RocketScientist26/Quadruped-Hardware/Servo/Manufacturing data/PCB_Bottom.png

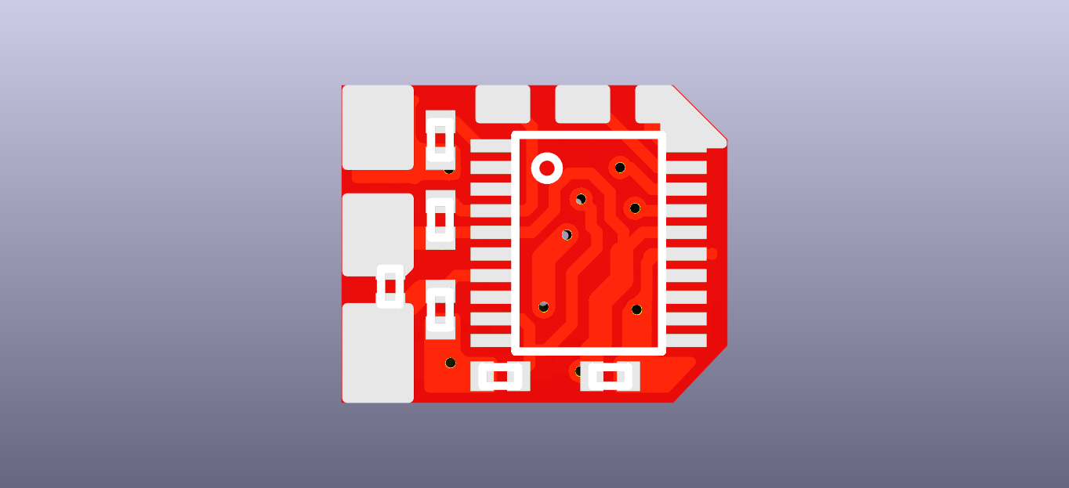
Servo/Manufacturing data/PCB_Bottom.png
