RocketScientist26/Quadruped-Hardware/Quadruped/Manufacturing data/PCB_Top.png

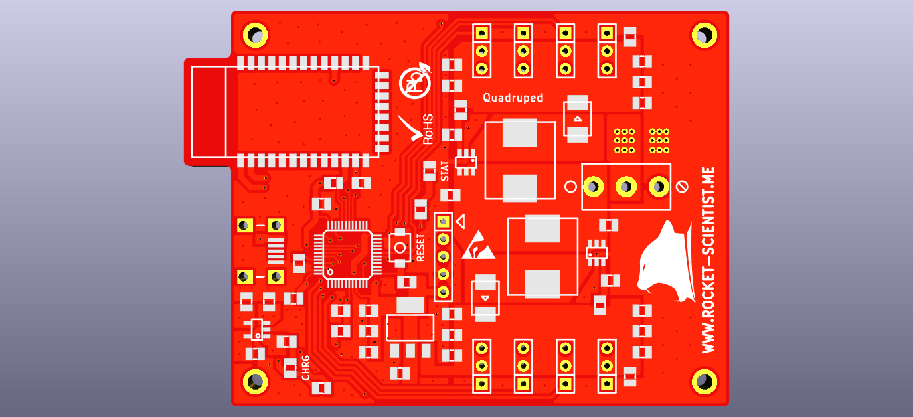
Quadruped/Manufacturing data/PCB_Top.png
