RocketScientist26/Quadruped-Hardware/README.md

# Quadruped-Hardware

Main, Battery protection and Servo PCBs for Quadruped robot

Project page: [https://rocket-scientist.me/quadruped.html](https://rocket-scientist.me/quadruped.html)
