RocketScientist26/Quadruped-Hardware/Quadruped/Manufacturing data/BOM.xlsx

 | BOM (Bill of Materials)
Item # | *Ref Des | *Qty | Manufacturer | *Mfg Part # | Description / Value | *Package | Type | Your Instructions / Notes | Taobao.com URL
1 | C7, C16, C19 | 3 |  |  | Capacitor 100nf 50v | 0805 | SMD |  | https://item.taobao.com/item.htm?id=557280840360
2 | C3, C4, C12, C15 | 4 |  |  | Capacitor 1uf 50v | 0805 | SMD |  | https://item.taobao.com/item.htm?id=538416549211
3 | C1, C2, C5, C6, C8, C9, C10, C11, C13, C14, C17, C18, C20, C21, C22, C23, C24, C25 | 18 |  |  | Capacitor 47uf 25v | 0805 | SMD |  | https://item.taobao.com/item.htm?id=538416665045
4 | D1 | 1 |  |  | LED ORANGE | 0805 | SMD |  | https://item.taobao.com/item.htm?id=525899852222
5 | D2 | 1 |  |  | LED RED | 0805 | SMD
6 | D3, D4 | 2 | MDD |  | Schottky Diode SK84 | DO-214AA(SMB) | SMD |  | https://item.taobao.com/item.htm?id=567102417769
7 | L1, L2 | 2 |  |  | Inductor 22uh 8A | 10mm*10mm*4mm | SMD |  | https://item.taobao.com/item.htm?id=558365384769
8 | R1 | 1 |  |  | Resistor 220Ohm | 0805 | SMD |  | https://item.taobao.com/item.htm?id=557364977141
9 | R2 | 1 |  |  | Resistor 1k 1% | 0805 | SMD |  | https://item.taobao.com/item.htm?id=554180010587
10 | R3, R9, R11 | 3 |  |  | Resistor 2k 1% | 0805 | SMD |  | https://item.taobao.com/item.htm?id=553896720937
11 | R8, R10 | 2 |  |  | Resistor 18k 1% | 0805 | SMD |  | https://item.taobao.com/item.htm?id=557364757827
12 | R4, R5, R7, R13 | 4 |  |  | Resistor 4.7k | 0805 | SMD |  | https://item.taobao.com/item.htm?id=557276456906
13 | R6 | 1 |  |  | Resistor 100k | 0805 | SMD |  | https://item.taobao.com/item.htm?id=557276576809
14 | SW2 | 1 |  |  | Pushbutton 3mm*4mm 2P |  | SMD |  | https://item.taobao.com/item.htm?id=537888444435
15 | U1 | 1 | ST Microelectronics |  | STM32F103C8T6 | LQFP48 | SMD |  | https://item.taobao.com/item.htm?id=563616201489
16 | U2 | 1 |  |  | TP4055 | SOT23-5 | SMD |  | https://item.taobao.com/item.htm?id=558938896276
17 | U3, U4 | 2 |  |  | MT3608 | TSOT23-6 | SMD |  | https://item.taobao.com/item.htm?id=534363904703
18 | U6 | 1 |  |  | AMS1117-3.3 | SOT223 | SMD |  | https://item.taobao.com/item.htm?id=525783568339
19 | K2, K3, K4, K5, K6, K7, K8, K9 | 8 |  |  | 2.54mm Pin Header 3P |  | Through-hole |  | https://item.taobao.com/item.htm?id=552150952223
20 | SW1 | 1 |  |  | Toggle Switch SS-12D10 |  | Through-hole |  | https://item.taobao.com/item.htm?id=558180762426
21 | P1 | 1 |  |  | USB Mini 5P Connector |  | SMD/Through-hole |  | https://item.taobao.com/item.htm?id=564449298750
22 | U5 | 1 |  |  | JDY-30 Bluetooth Module |  | SMD |  | https://item.taobao.com/item.htm?id=550104786746
