RocketScientist26/Quadruped-Hardware/Battery/Manufacturing data/Schematics.pdf

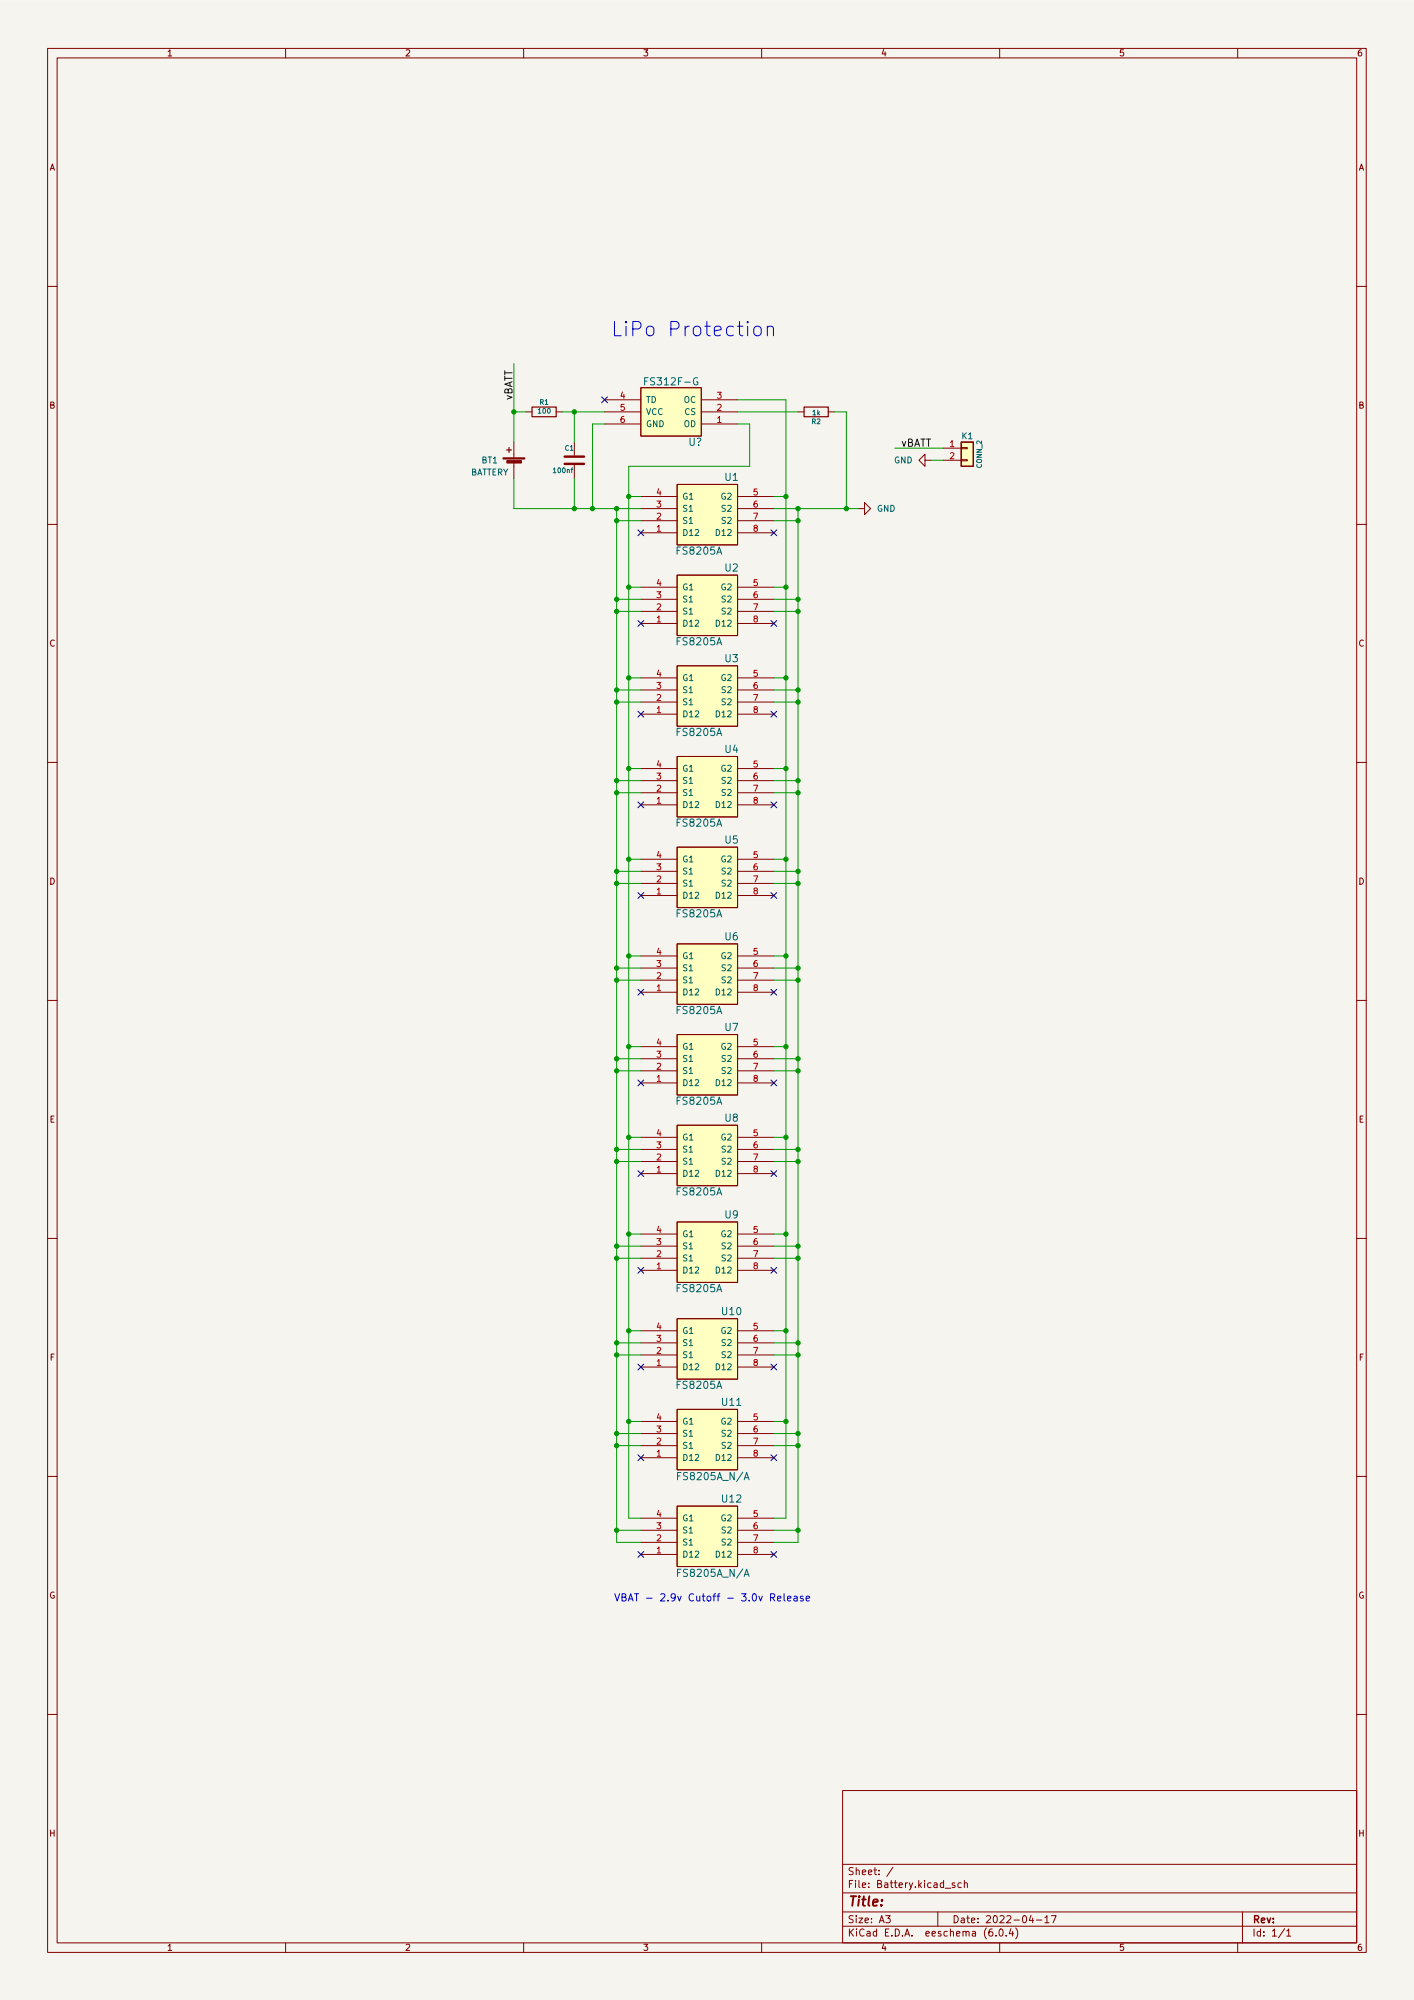
[picture p3: page 1]
