RocketScientist26/Quadruped-Hardware/Quadruped/Manufacturing data/Schematics.pdf

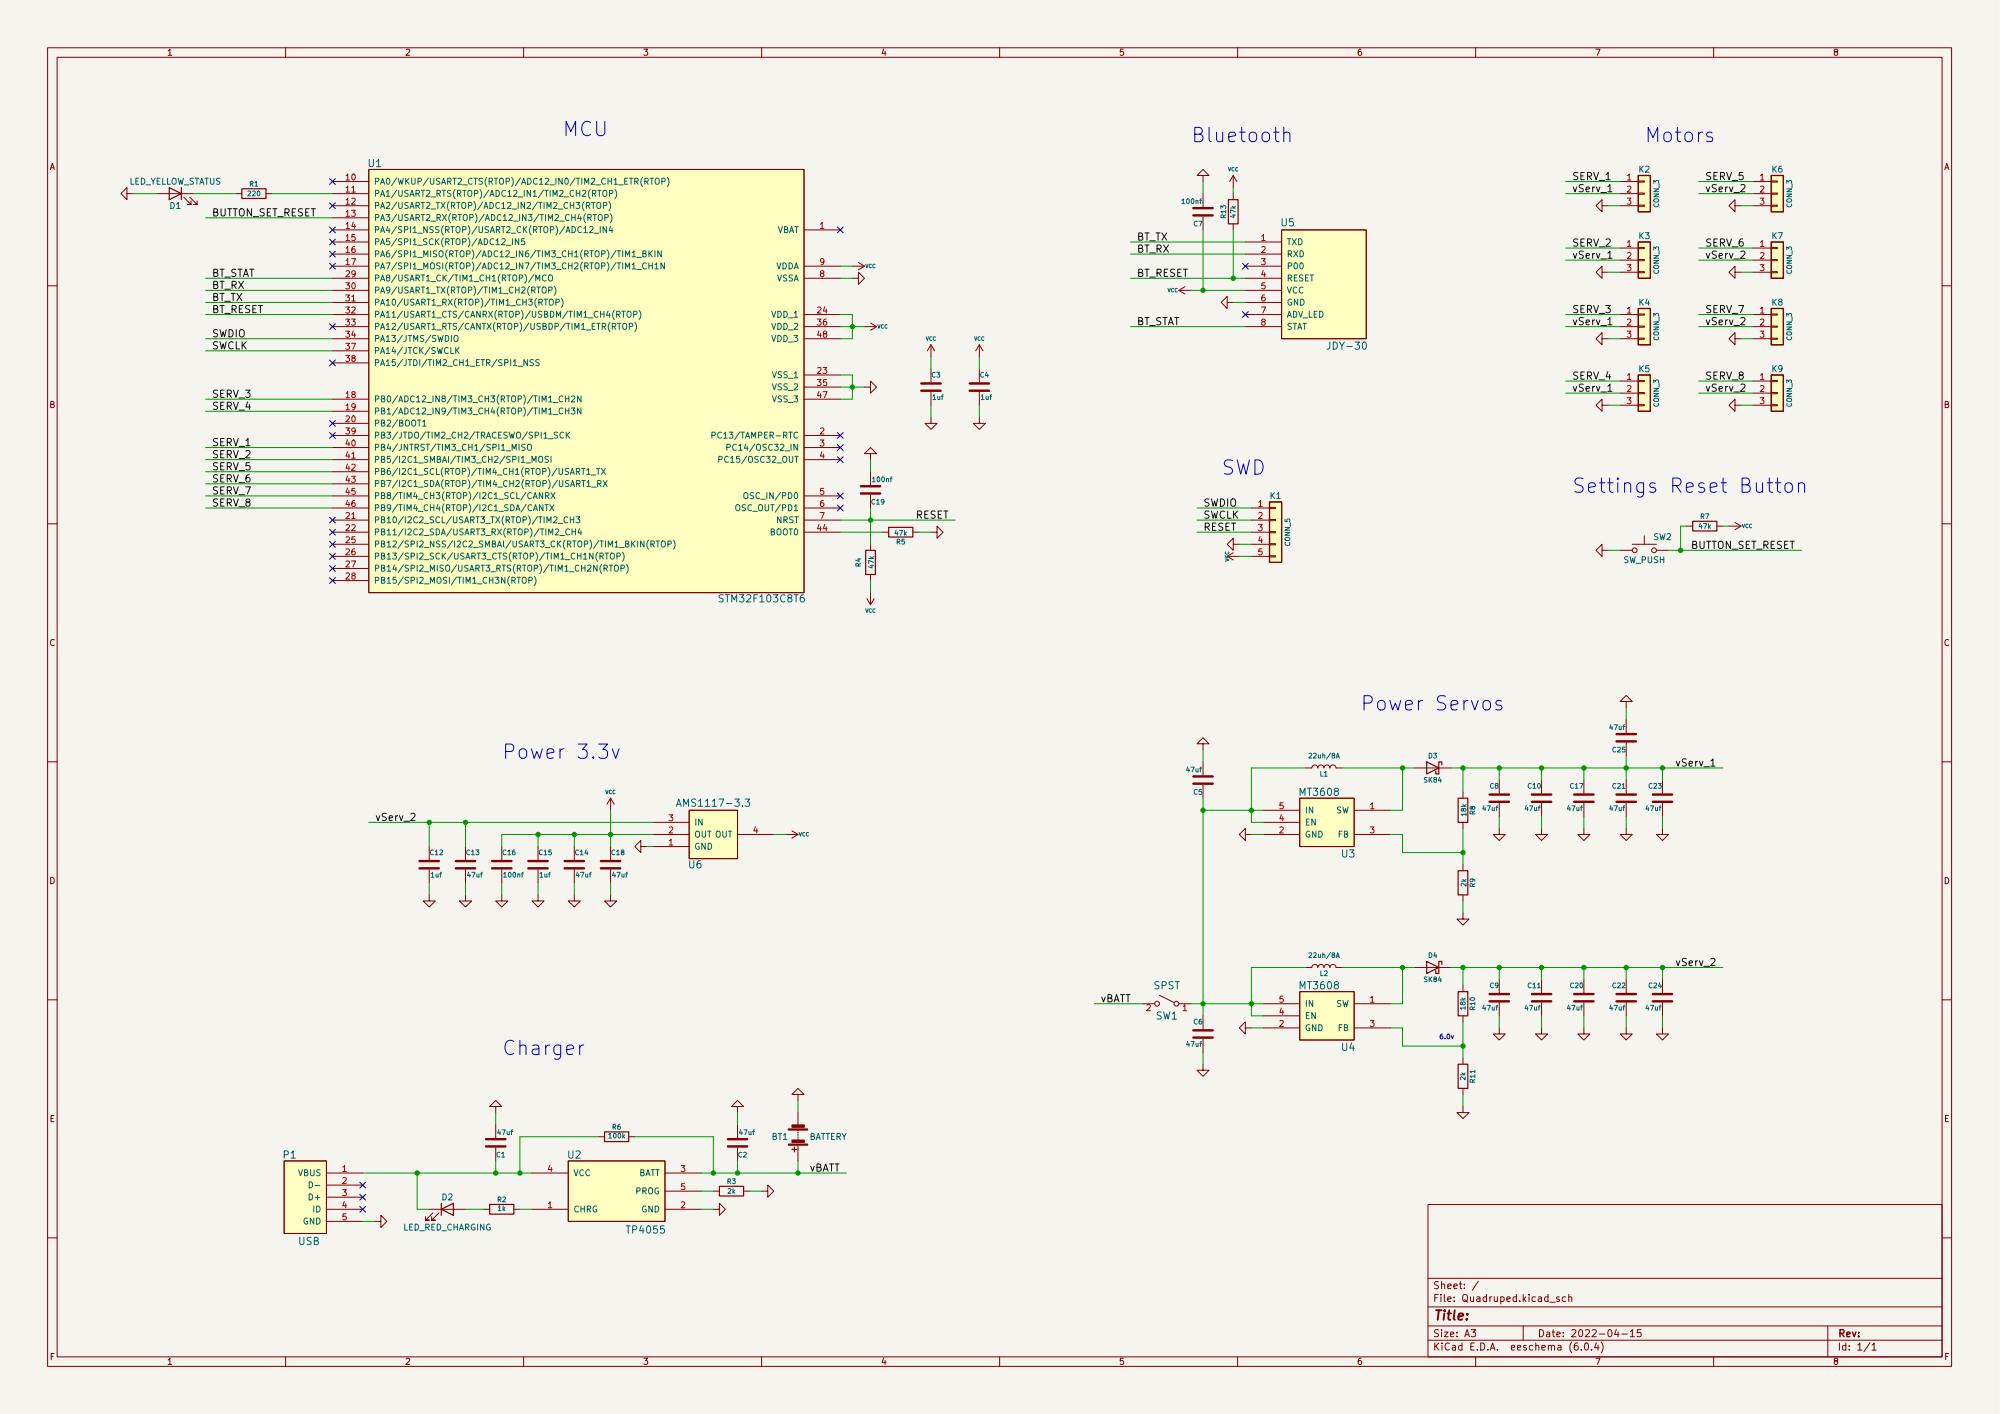
[picture p4: page 1]
