RocketScientist26/Quadruped-Hardware/Servo/Manufacturing data/Schematics.pdf

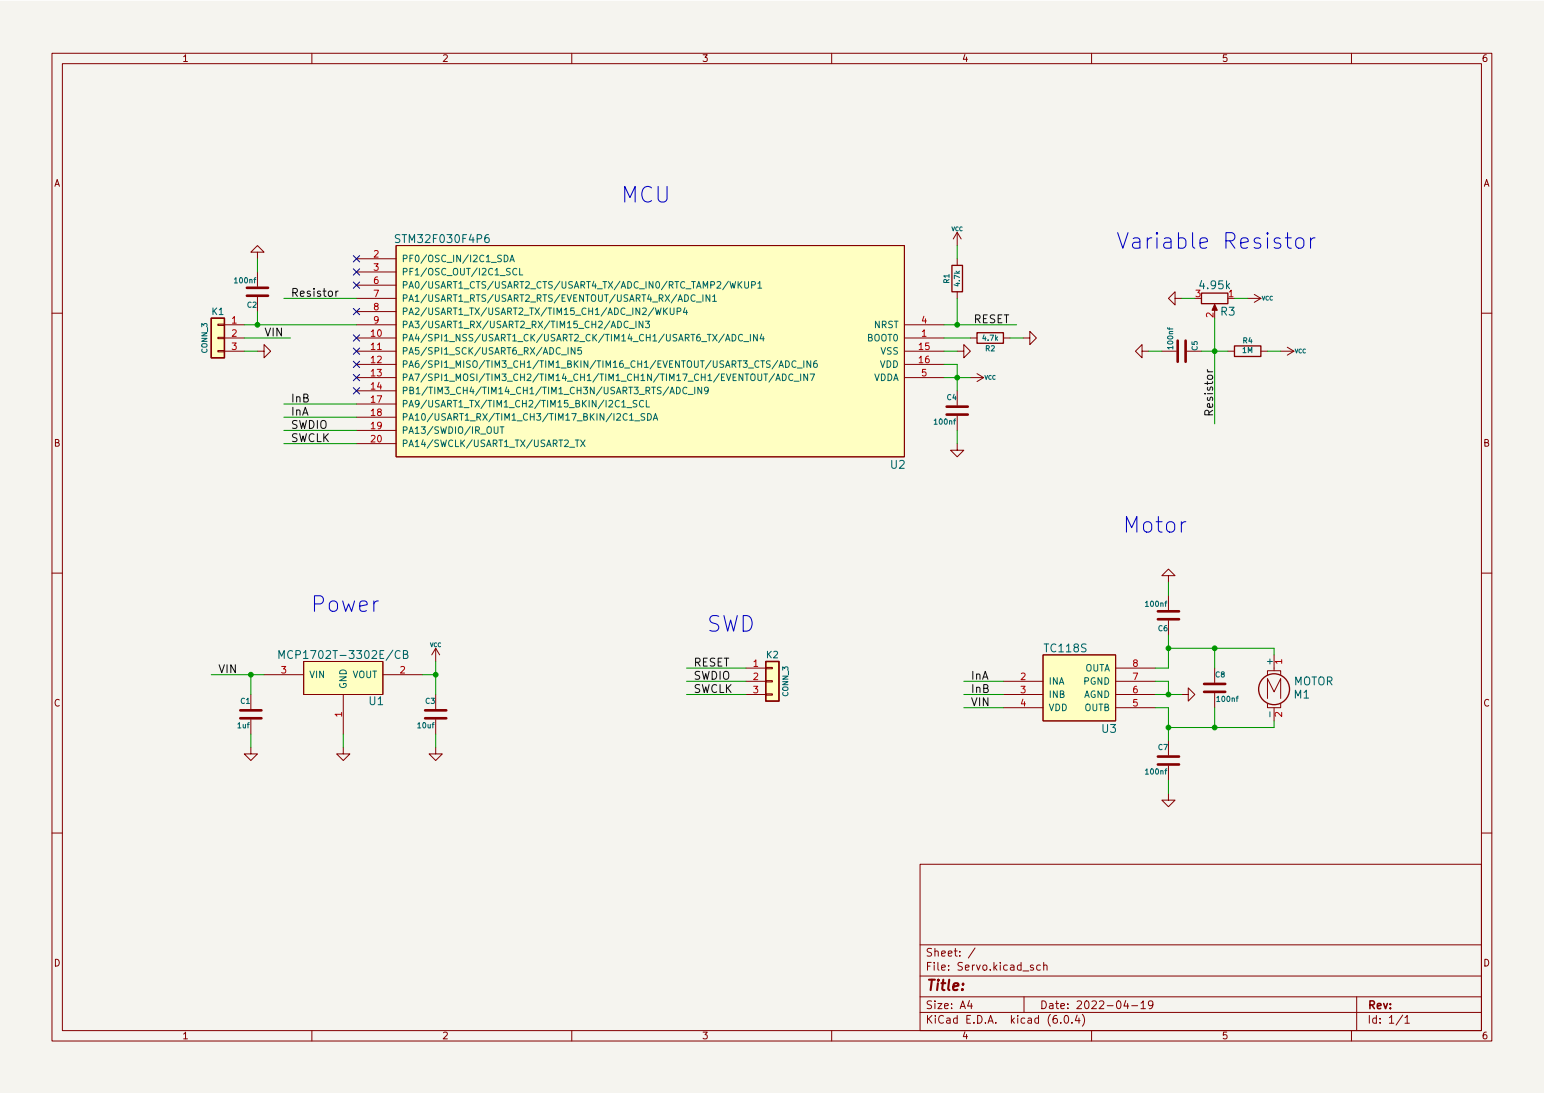
[picture p5: page 1]
