RocketScientist26/Quadruped-Hardware/Quadruped/Manufacturing data/Assembly notes/Placement.pdf

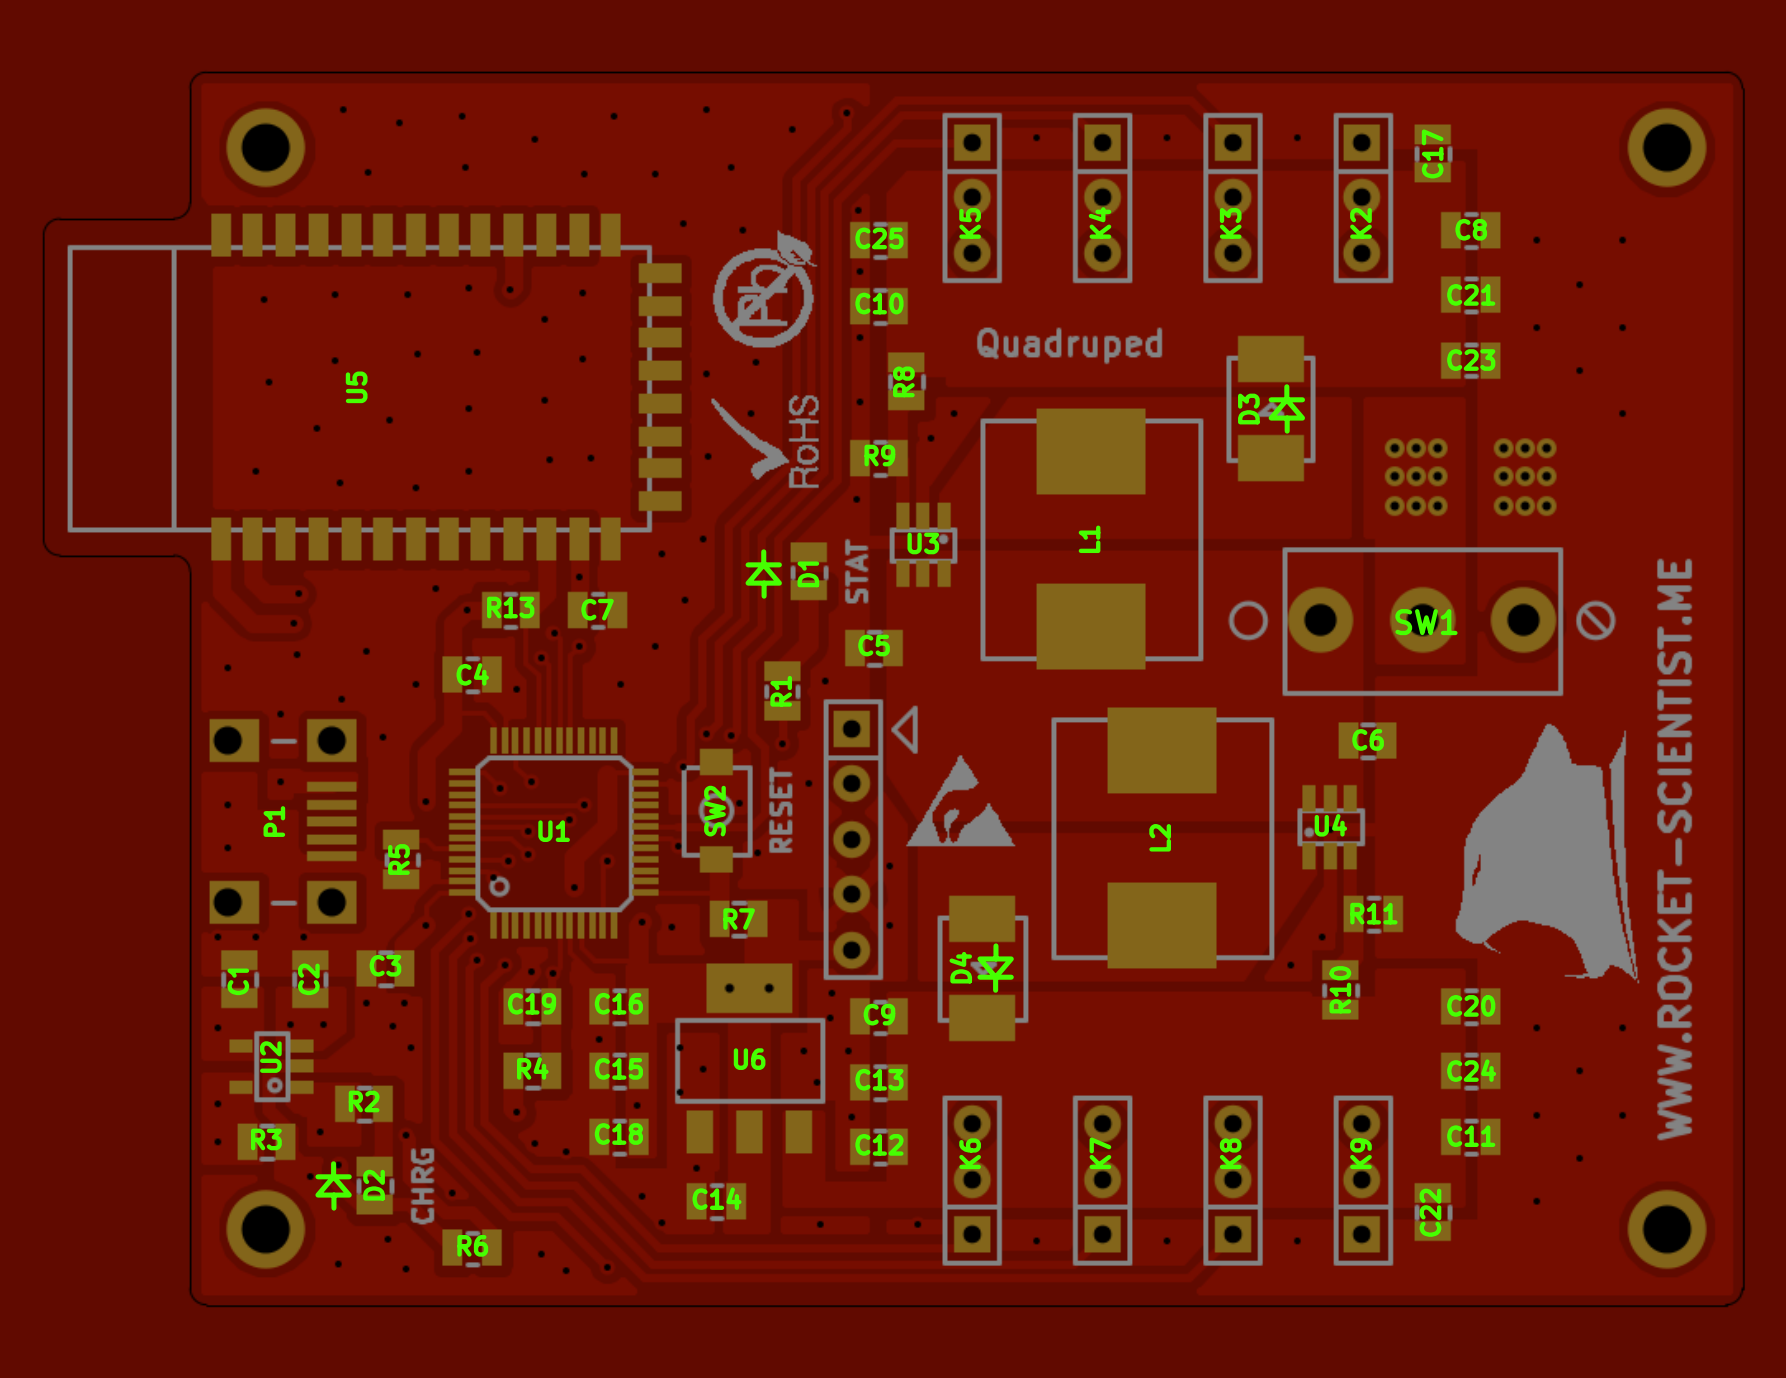
[picture p6: page 1]
