RocketScientist26/Quadruped-Hardware/Servo/Servo.kicad_pcb

## KiCad design Servo/Servo.kicad_pcb (2022-04-24)

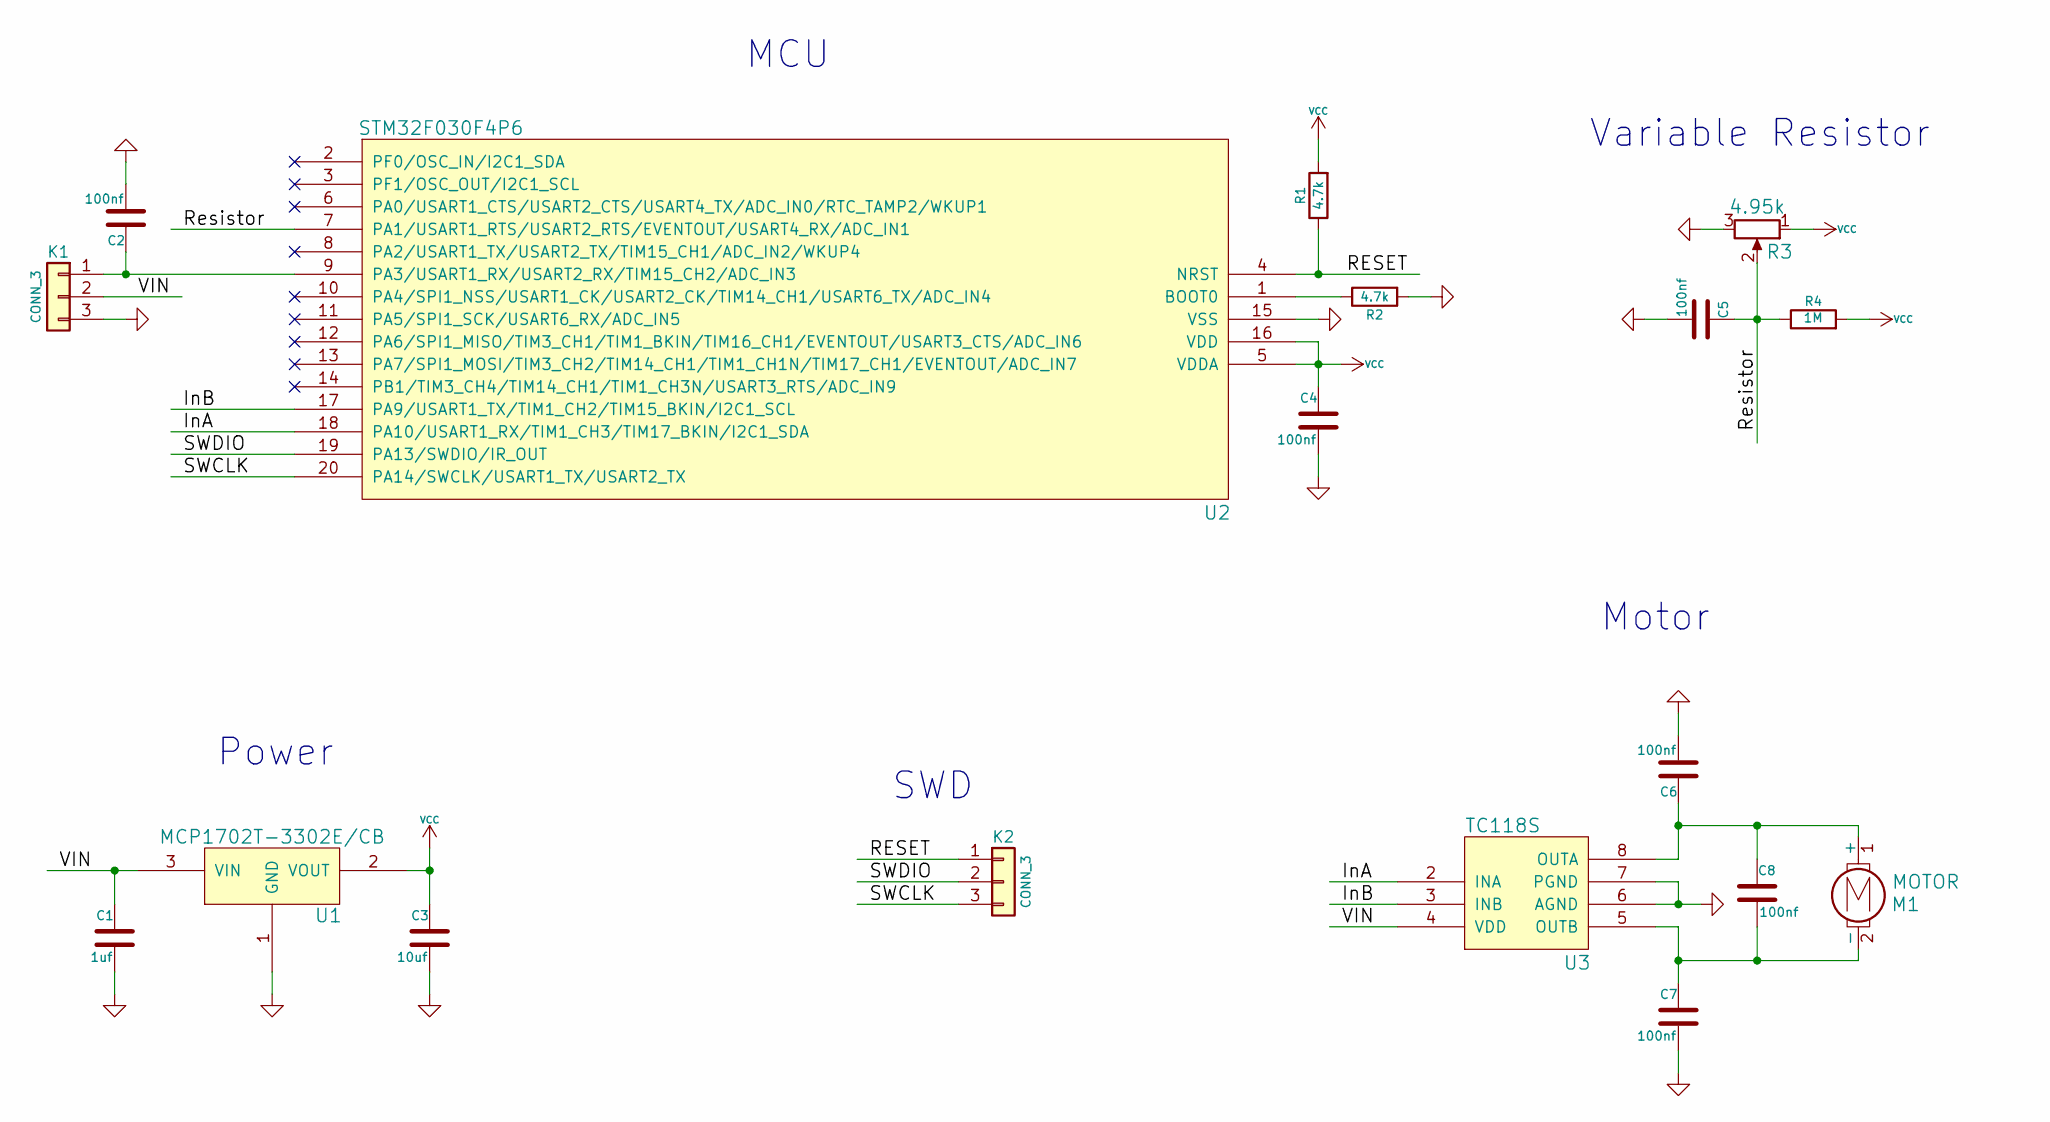
[picture p7: schematic Servo.kicad_sch]

Parts:
C1: 1uf; SM0402
C2, C4, C5, C6, C7, C8: 100nf; SM0402
C3: 10uf; SM0402
K1: CONN_3; SIL3_MDS
K2: CONN_3; SIL3_D
M1: MOTOR; SIL2_MD
R1, R2: 4.7k; SM0402
R3: 4.95k; SIL3_MD
R4: 1M; SM0402
U1: MCP1702T-3302E/CB; SOT23
U2: STM32F030F4P6; TSSOP20
U3: TC118S; SOP8

Connections:
/InA: U2.18 (PA10/USART1_RX/TIM1_CH3/TIM17_BKIN/I2C1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), U3.2 (INA)
/InB: U2.17 (PA9/USART1_TX/TIM1_CH2/TIM15_BKIN/I2C1_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), U3.3 (INB)
/RESET: K2.1, R1.1, U2.4 (NRST)
/Resistor: C5.1, R3.2, R4.1, U2.7 (PA1/USART1_RTS/USART2_RTS/EVENTOUT/USAR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)
/SWCLK: K2.3, U2.20 (PA14/SWCLK/USART1_TX/USART2_TX)
/SWDIO: K2.2, U2.19 (PA13/SWDIO/IR_OUT)
/VIN: C1.1, K1.2, U1.3 (VIN), U3.4 (VDD)
GND: C1.2, C2.2, C3.2, C4.2, C5.2, C6.2, C7.2, K1.3, R2.2, R3.3, U1.1 (GND), U2.15 (VSS), U3.6 (AGND), U3.7 (PGND)
unnamed: C2.1, K1.1, U2.9 (PA3/USART1_RX/USART2_RX/TIM15_CH2/ADC_I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), U3.1
unnamed: R2.1, U2.1 (BOOT0)
unnamed: C6.1, C8.1, M1.1 (+), U3.8 (OUTA)
unnamed: C7.1, C8.2, M1.2 (-), U3.5 (OUTB)
VCC: C3.1, C4.1, R1.2, R3.1, R4.2, U1.2 (VOUT), U2.5 (VDDA), U2.16 (VDD)

Notes on the sheet:
MCU
SWD
Variable Resistor
Power
Motor

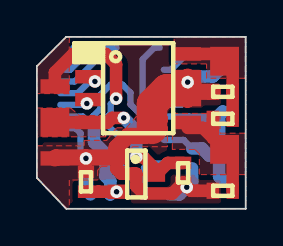
[picture p8: board Servo.kicad_pcb from above]

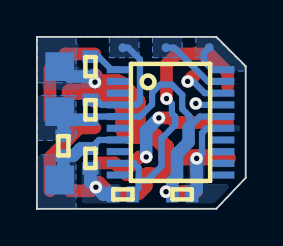
[picture p9: board Servo.kicad_pcb from below]

Board: 2 copper layers, 11.6 x 9.5 mm, 18 parts (9 on the bottom side), 13 nets.
