RocketScientist26/Quadruped-Hardware/Battery/Manufacturing data/Assembly notes/Placement.jpg

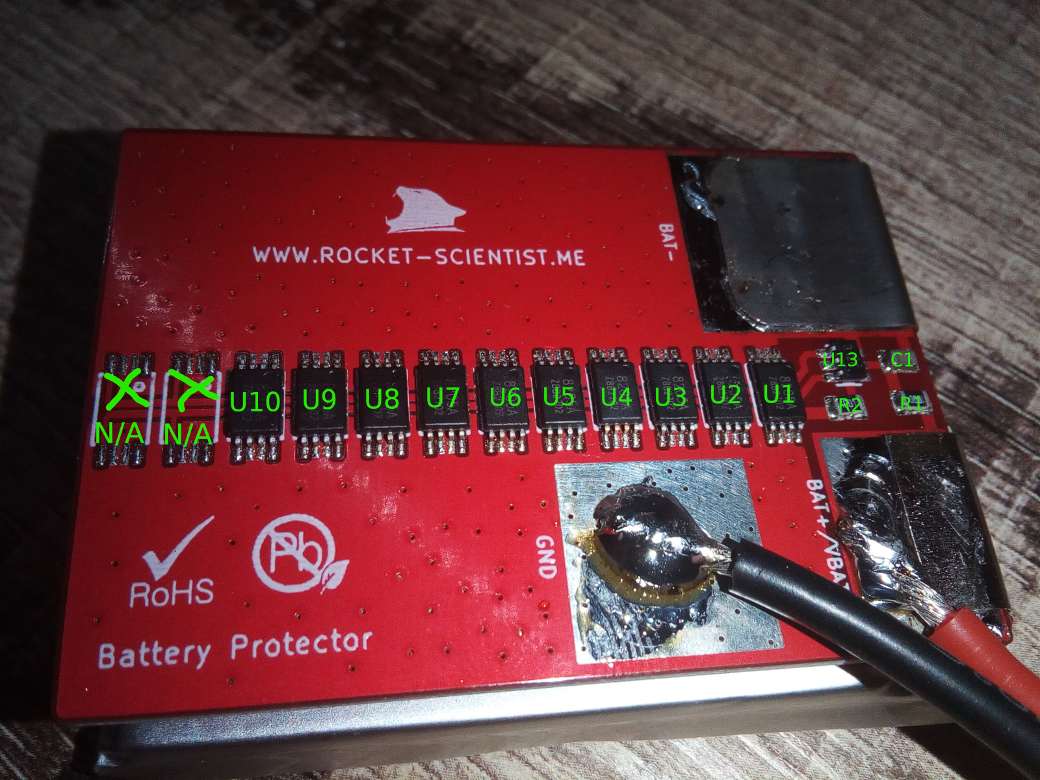
Battery/Manufacturing data/Assembly notes/Placement.jpg
