RocketScientist26/Quadruped-Hardware/Battery/Manufacturing data/PCB_Bottom.png

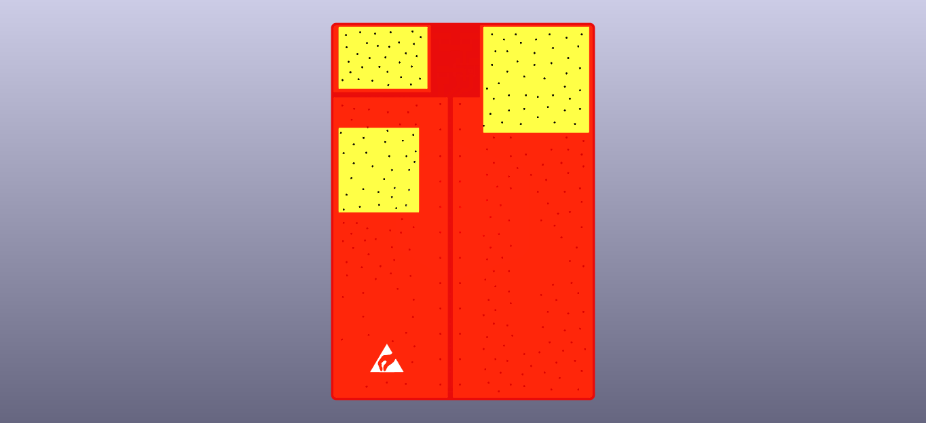
Battery/Manufacturing data/PCB_Bottom.png
