RocketScientist26/Quadruped-Hardware/Battery/Manufacturing data/PCB_Top.png

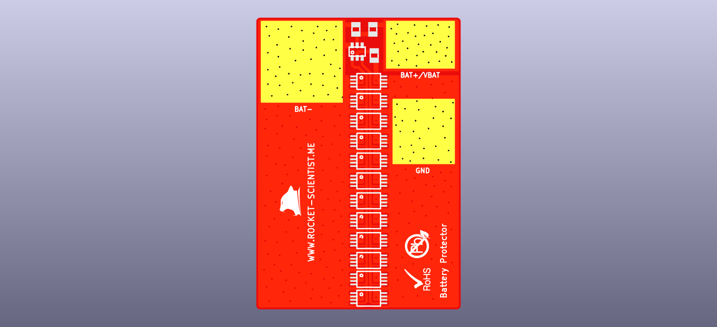
Battery/Manufacturing data/PCB_Top.png
