RocketScientist26/Quadruped-Hardware/Quadruped/Manufacturing data/PCB_Bottom.png

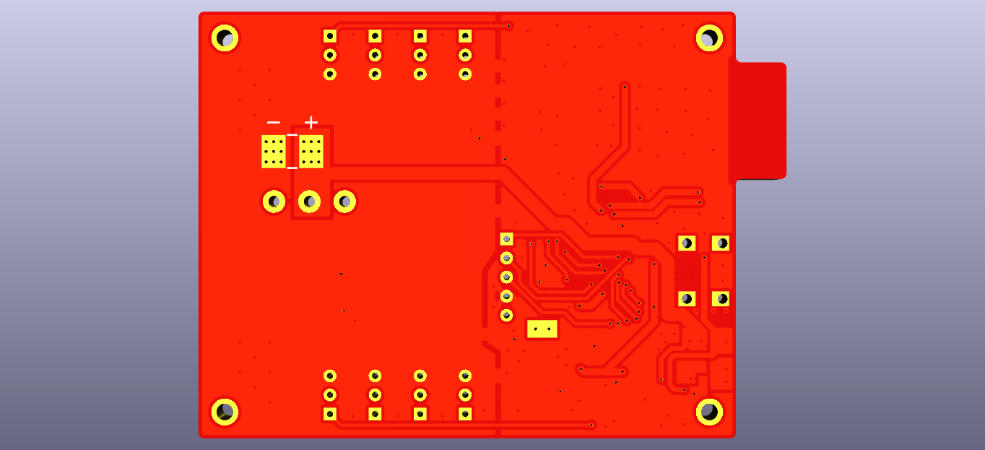
Quadruped/Manufacturing data/PCB_Bottom.png
