RocketScientist26/Quadruped-Hardware/Servo/Manufacturing data/PCB_Top.png

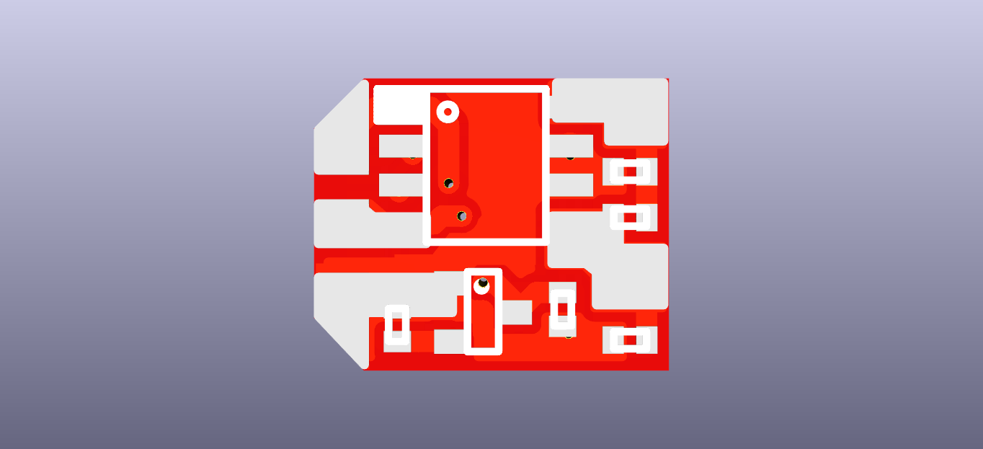
Servo/Manufacturing data/PCB_Top.png
